clockdiv/mollusc-motion-hardware/mollusc_motion_board/v1.2/Screenshots/Screenshot 2024-01-08 at 12.20.10.png

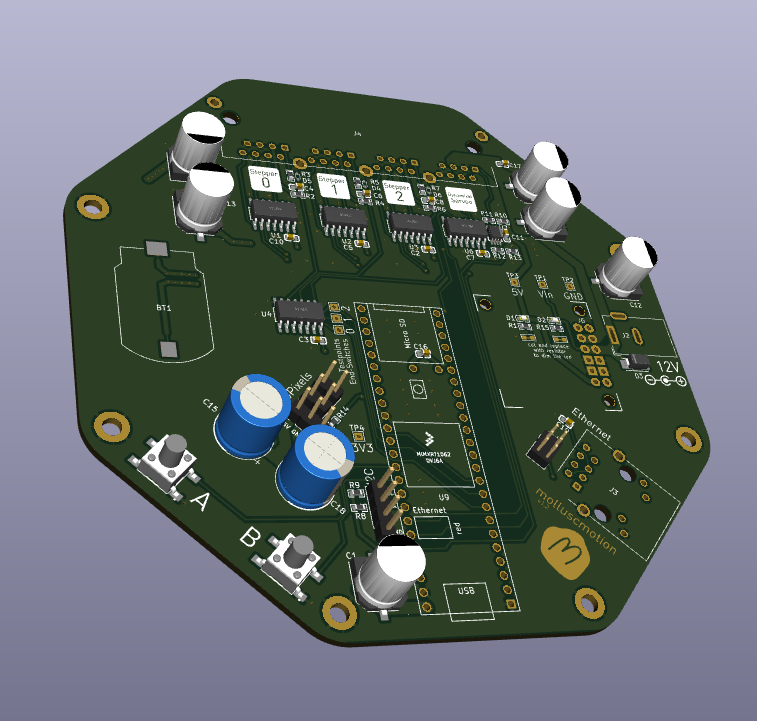
mollusc_motion_board/v1.2/Screenshots/Screenshot 2024-01-08 at 12.20.10.png
