clockdiv/mollusc-motion-hardware/20240207_mollusc_motion_board_v1-2.step

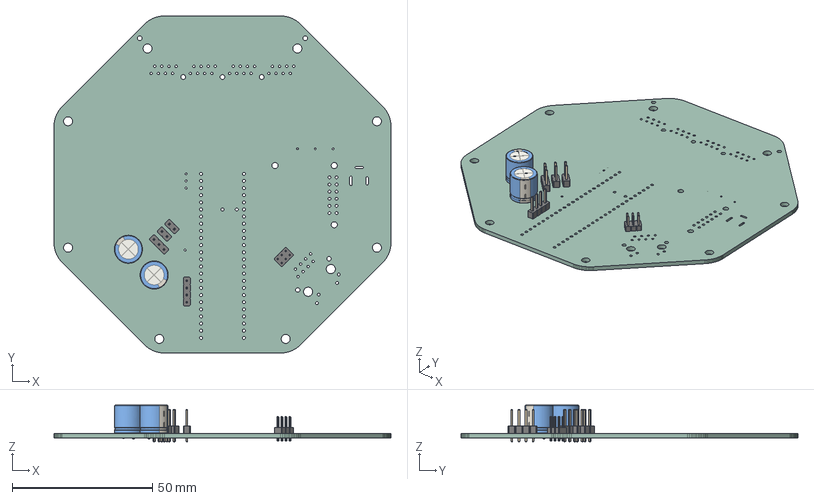
[picture p4: CAD file, 2024-07-25]
20240207_mollusc_motion_board_v1-2.step
120.0 x 120.0 x 13.0 mm
mollusc_motion_board PCB
