clockdiv/mollusc-motion-hardware/20240105_PCB_Outline_12cm.dxf

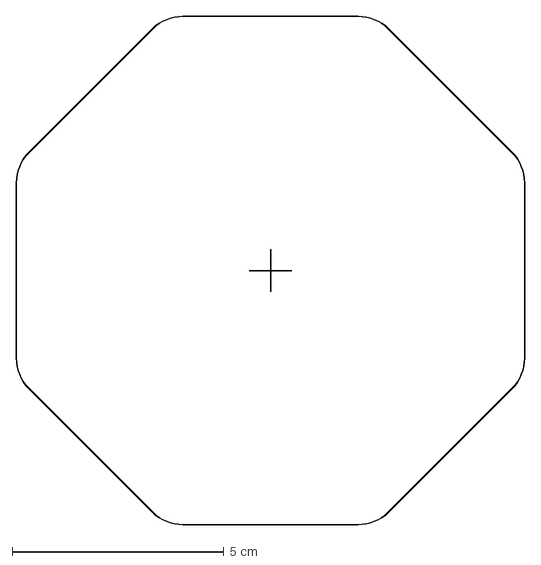
[picture p5: CAD file, 2024-01-05]
20240105_PCB_Outline_12cm.dxf
12.0 x 12.0 cm
