clockdiv/mollusc-motion-hardware/20240104_PCB_Outline_12cm.dxf

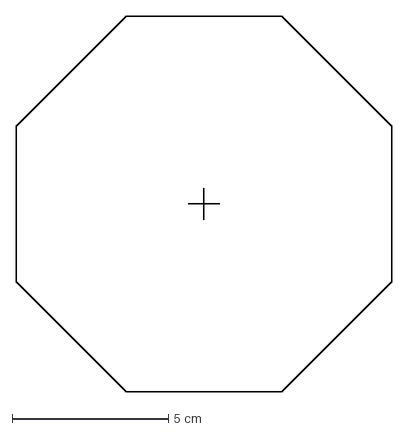
[picture p6: CAD file, 2024-01-04]
20240104_PCB_Outline_12cm.dxf
12.0 x 12.0 cm
