clockdiv/mollusc-motion-hardware/20240102_PCB_Outline_with_centerlines.dxf

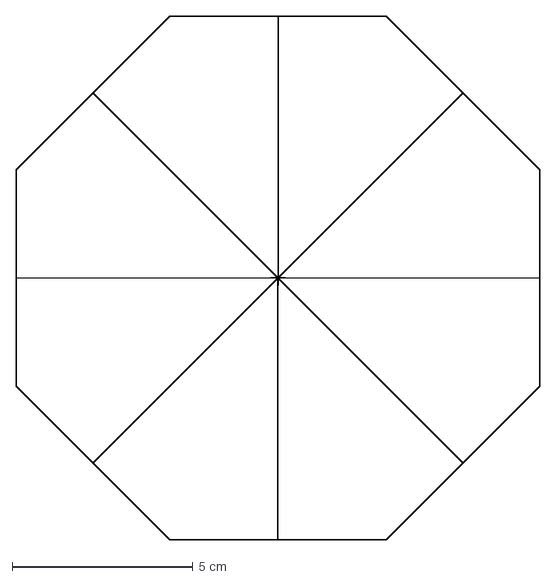
[picture p7: CAD file, 2024-01-04]
20240102_PCB_Outline_with_centerlines.dxf
14.5 x 14.5 cm
