clockdiv/mollusc-motion-hardware/20240104_Neopixel_Rings.dxf

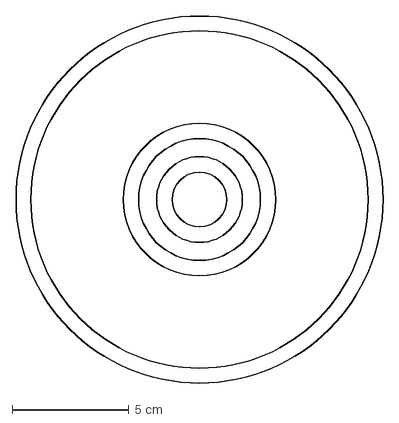
[picture p8: CAD file, 2024-01-04]
20240104_Neopixel_Rings.dxf
15.7 x 15.7 cm
