clockdiv/mollusc-motion-hardware/20240102_PCB_Outline.dxf

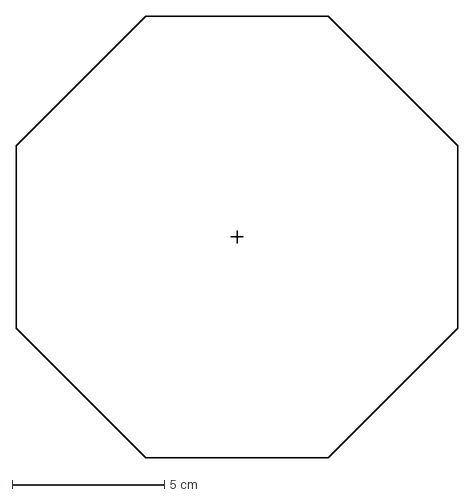
[picture p9: CAD file, 2024-01-04]
20240102_PCB_Outline.dxf
14.5 x 14.5 cm
