clockdiv/mollusc-motion-hardware/mollusc_motion_board/v1.2/20240124_Schematics.pdf

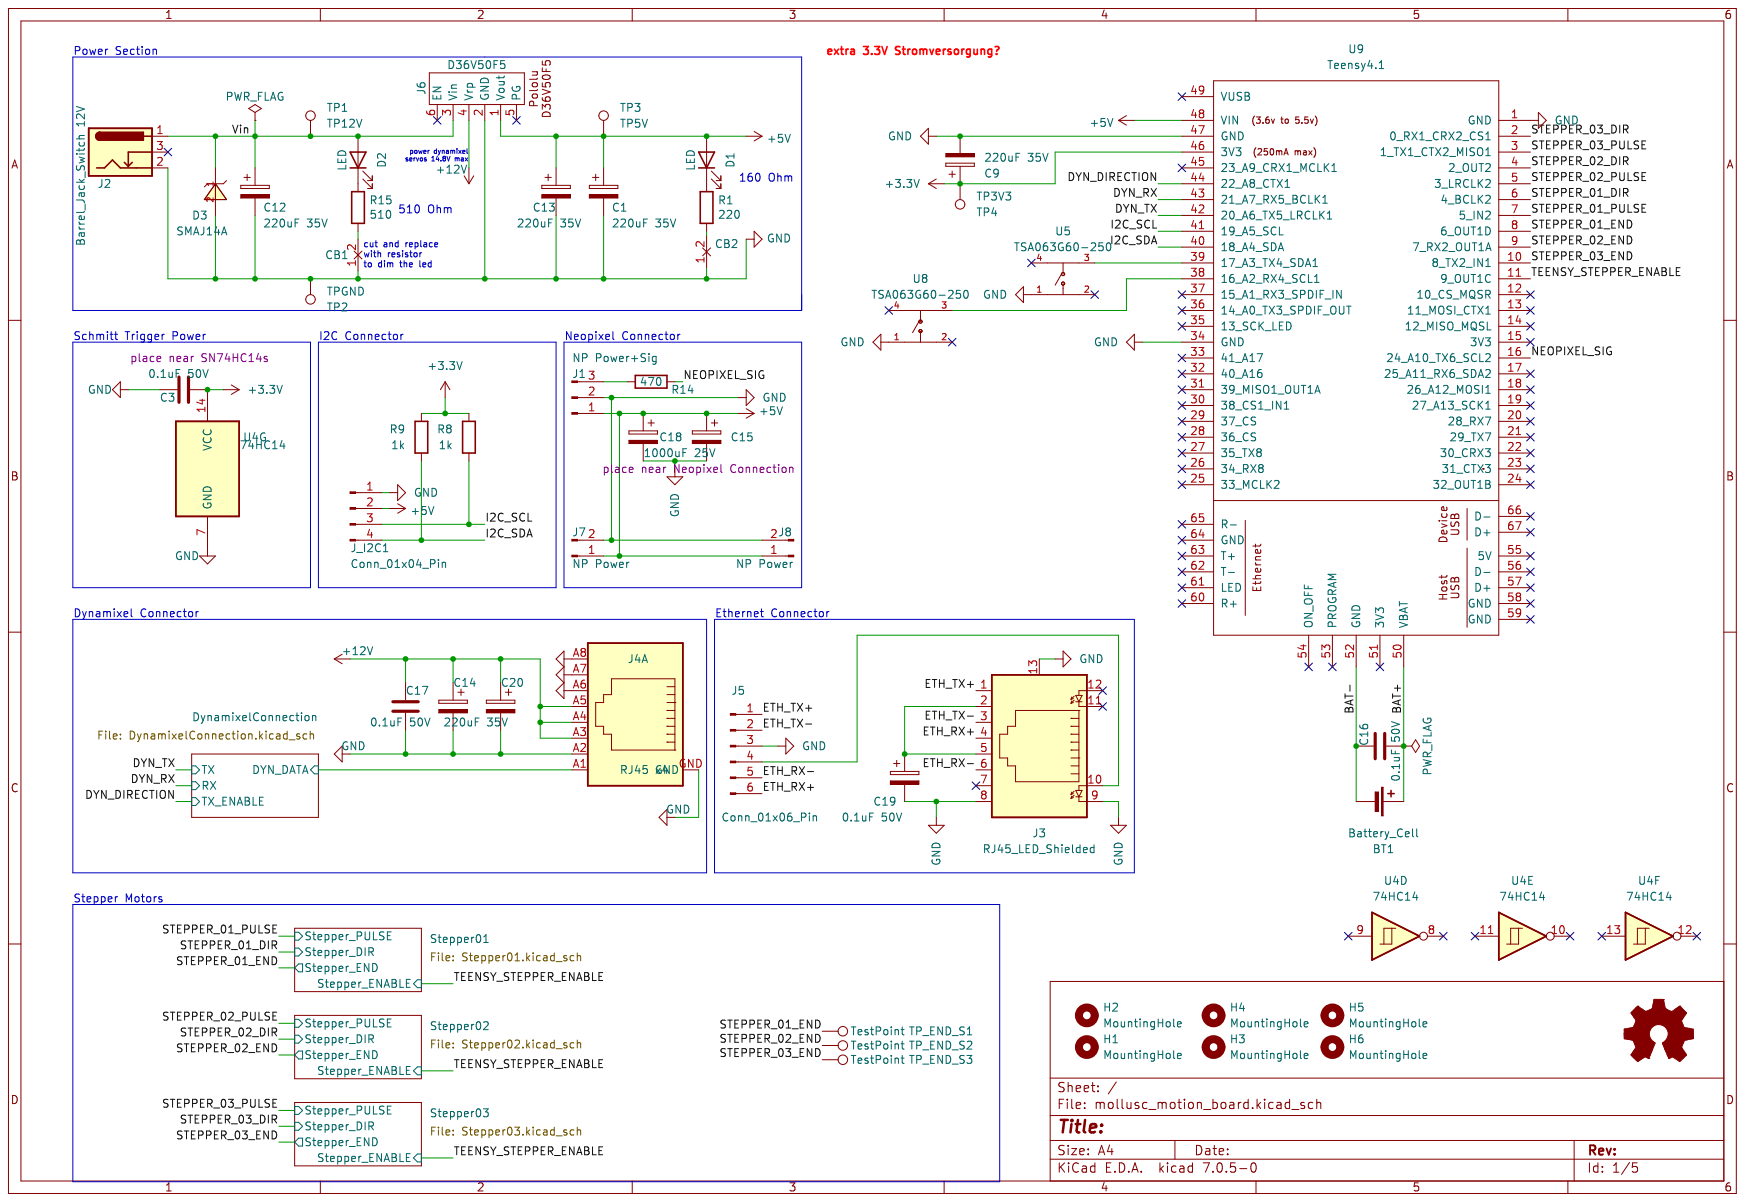
[picture p10: page 1]

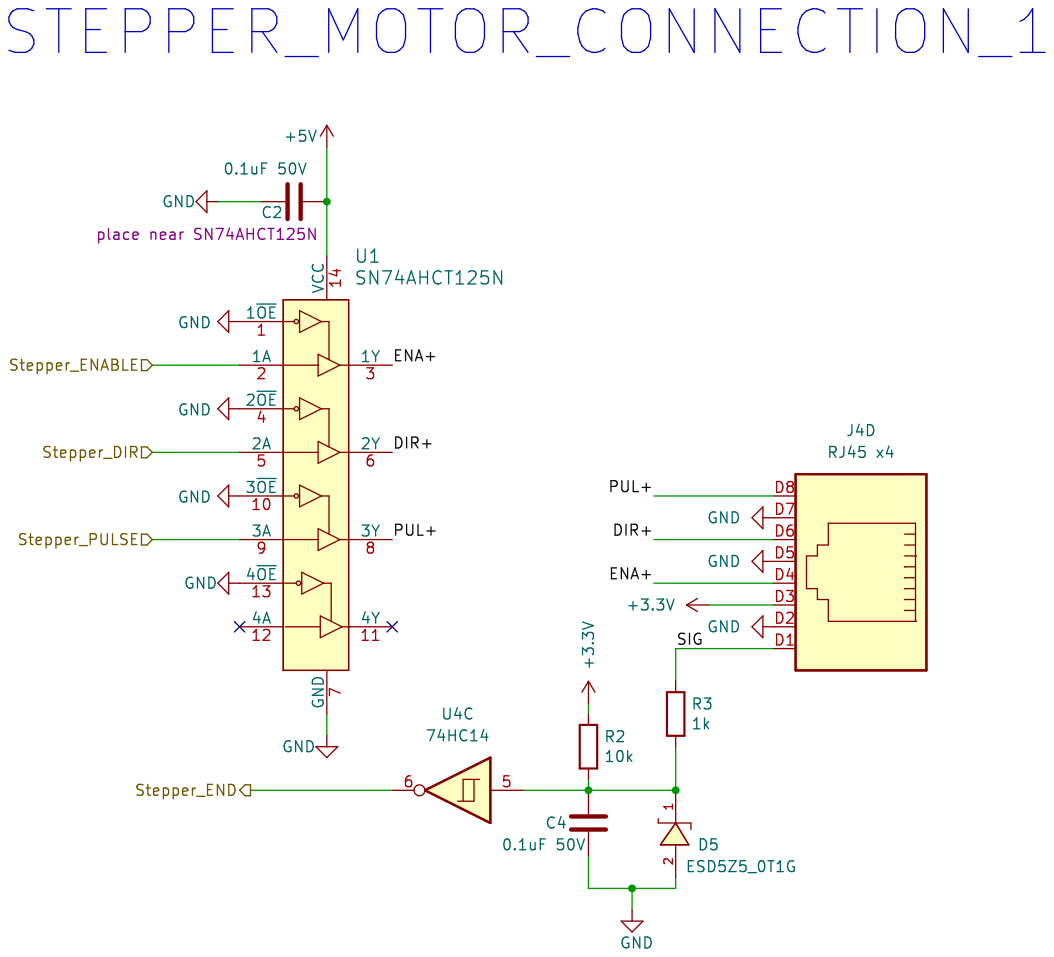
[picture p11: page 2]

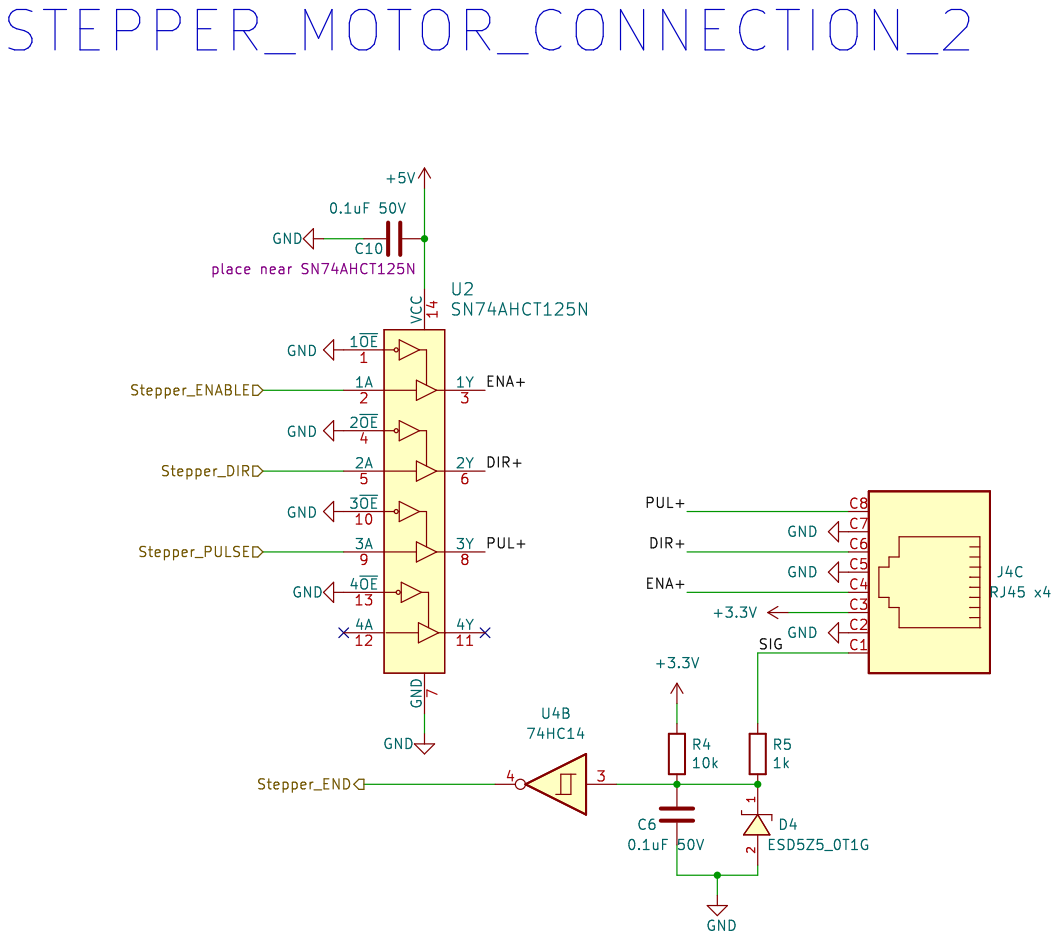
[picture p12: page 3]

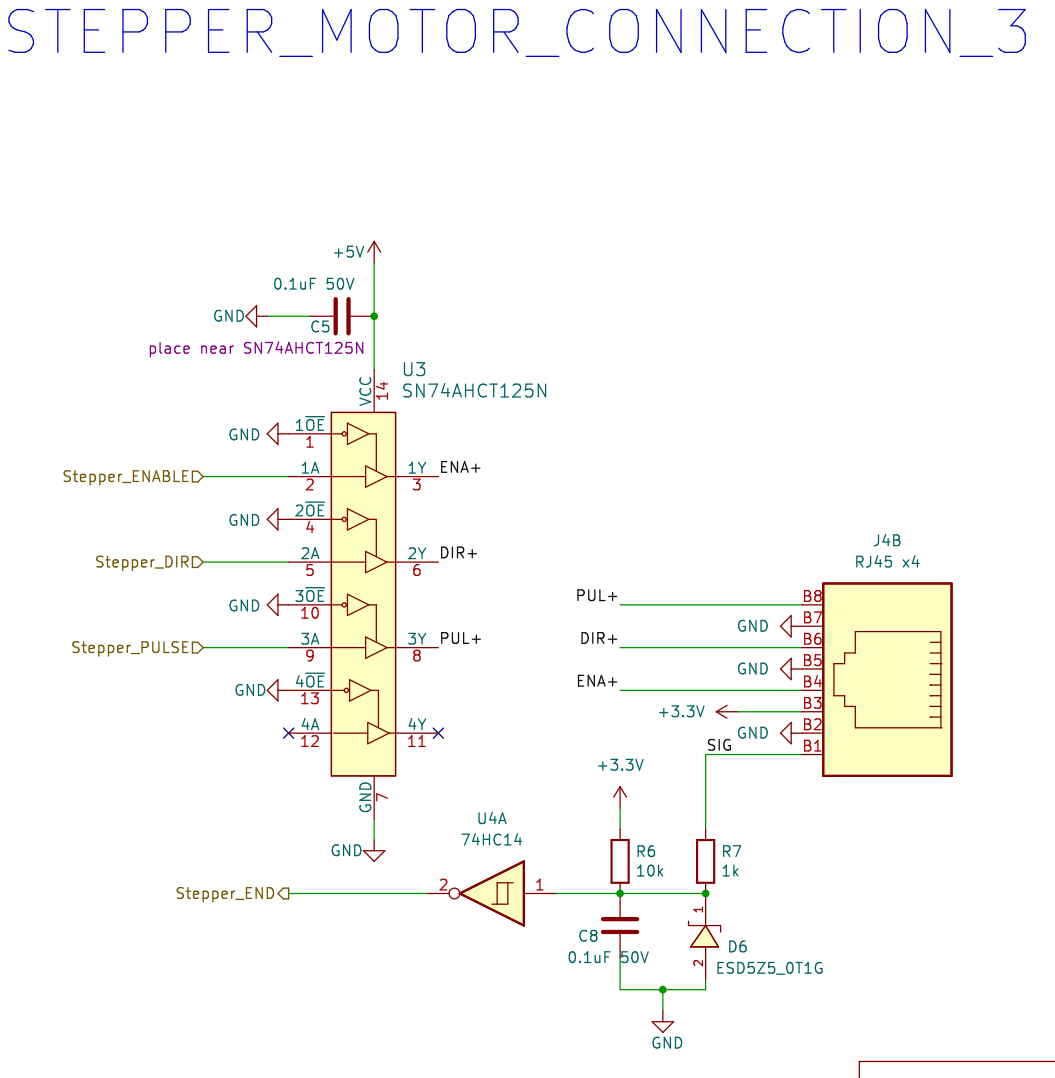
[picture p13: page 4]

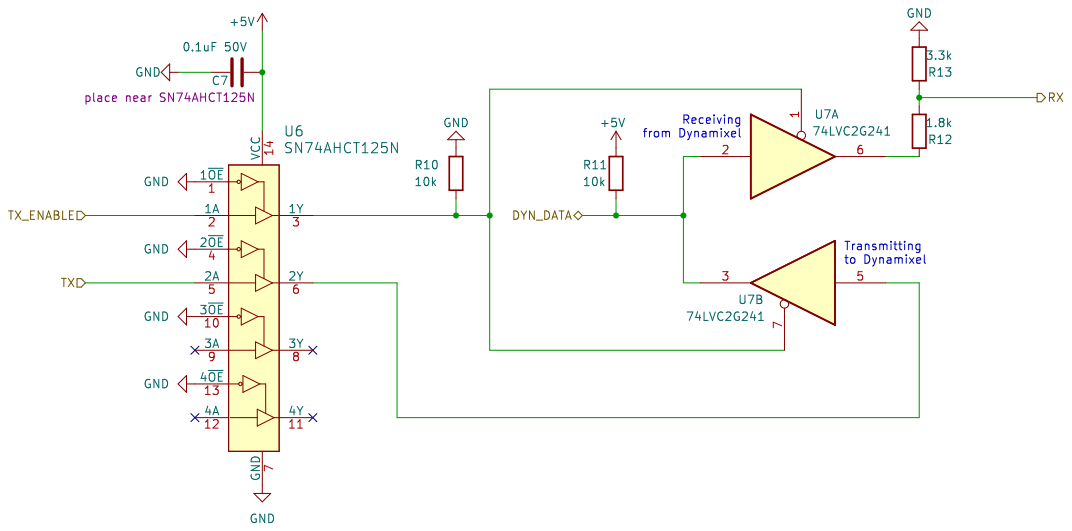
[picture p14: page 5]
