clockdiv/mollusc-motion-hardware/mollusc_motion_rj45-dynamixel-adapter/rj45-dynamixel-adapter.kicad_pcb

## KiCad design mollusc_motion_rj45-dynamixel-adapter/rj45-dynamixel-adapter.kicad_pcb (2024-08-13)

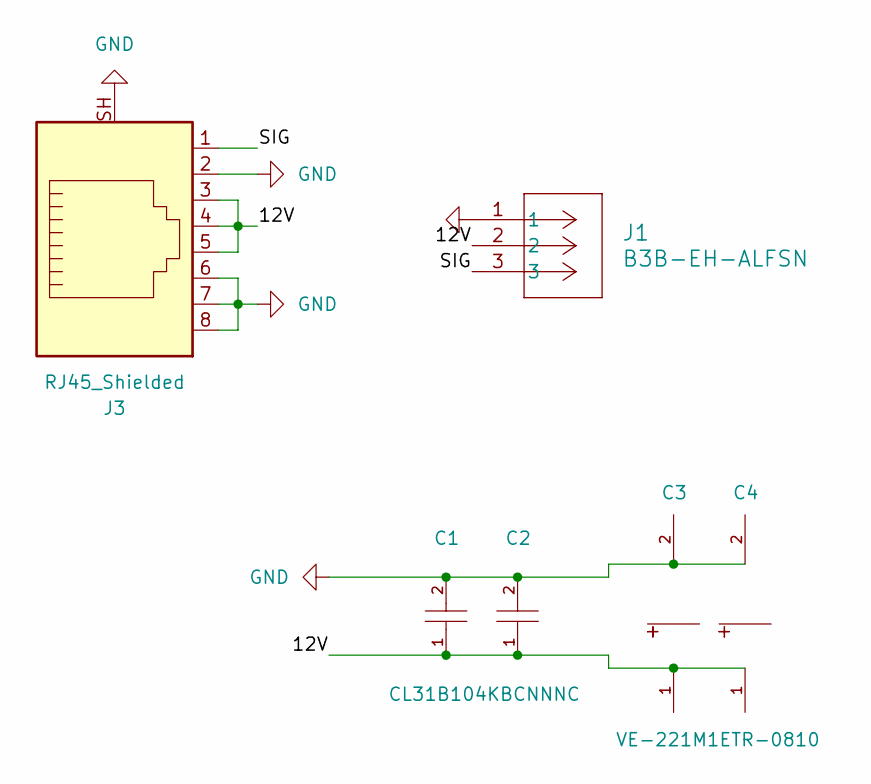
[picture p15: schematic rj45-dynamixel-adapter.kicad_sch]

Parts:
C1, C2: CL31B104KBCNNNC; C1206; LCSC C24497
C3, C4: VE-221M1ETR-0810; CAP-SMD_BD8.0-L8.3-W8.3-RD; LCSC C127967
J1: B3B-EH-ALFSN; CONN3_B3B-EH-ALFSN_JST
J3: RJ45_Shielded; RJ45_Conrad_1586526

Connections:
/12V: C1.1, C2.1, C3.1, C4.1, J1.2, J3.3, J3.4, J3.5
/SIG: J1.3, J3.1
GND: C1.2, C2.2, C3.2, C4.2, J1.1, J3.2, J3.6, J3.7, J3.8, J3.SH

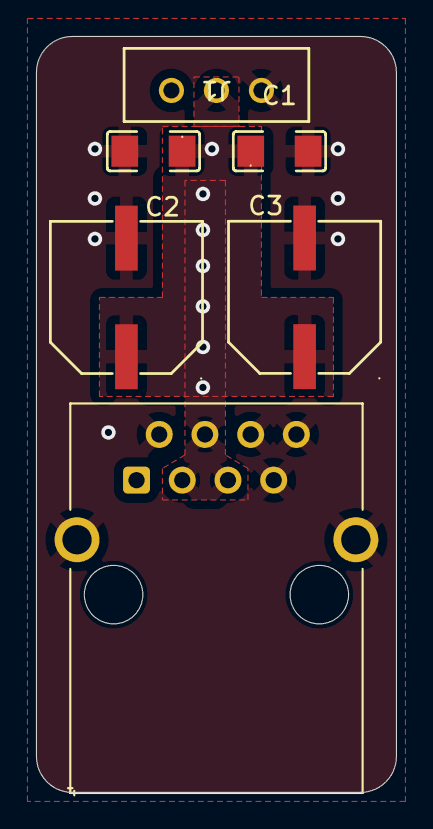
[picture p16: board rj45-dynamixel-adapter.kicad_pcb from above]

Board: 4 copper layers, 20.0 x 42.0 mm, 6 parts (0 on the bottom side), 3 nets.
