clockdiv/mollusc-motion-hardware/mollusc_motion_rj45-stepper-adapter_CL57T/rj45-stepper-adapter.kicad_pcb

## KiCad design mollusc_motion_rj45-stepper-adapter_CL57T/rj45-stepper-adapter.kicad_pcb (2024-07-25)

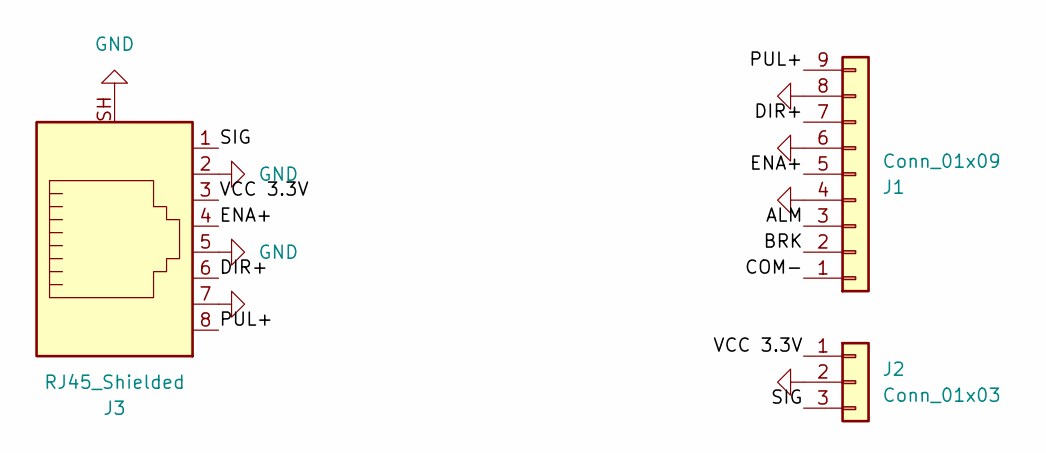
[picture p17: schematic rj45-stepper-adapter.kicad_sch]

Parts:
J1: Conn_01x09; Terminalblock_1x9_3.5mm
J2: Conn_01x03; PinHeader_1x03_P2.54mm_Vertical
J3: RJ45_Shielded; RJ45_Conrad_1586526

Connections:
/ALM: J1.3
/BRK: J1.2
/COM-: J1.1
/DIR+: J1.7, J3.6
/ENA+: J1.5, J3.4
/PUL+: J1.9, J3.8
/SIG: J2.3, J3.1
/VCC 3.3V: J2.1, J3.3
GND: J1.4, J1.6, J1.8, J2.2, J3.2, J3.5, J3.7, J3.SH

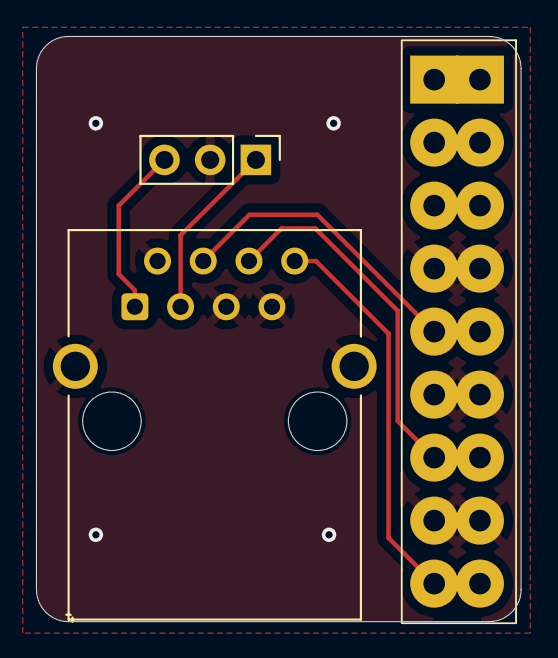
[picture p18: board rj45-stepper-adapter.kicad_pcb from above]

Board: 2 copper layers, 26.9 x 32.5 mm, 3 parts (0 on the bottom side), 6 nets.
