clockdiv/mollusc-motion-hardware/JST_EH_2.5mm_ExtensionBoard/JST_EH_2.5mm_ExtensionBoard/JST_EH_2.5mm_ExtensionBoard.kicad_pcb

## KiCad design JST_EH_2.5mm_ExtensionBoard/JST_EH_2.5mm_ExtensionBoard/JST_EH_2.5mm_ExtensionBoard.kicad_pcb (2024-07-25)

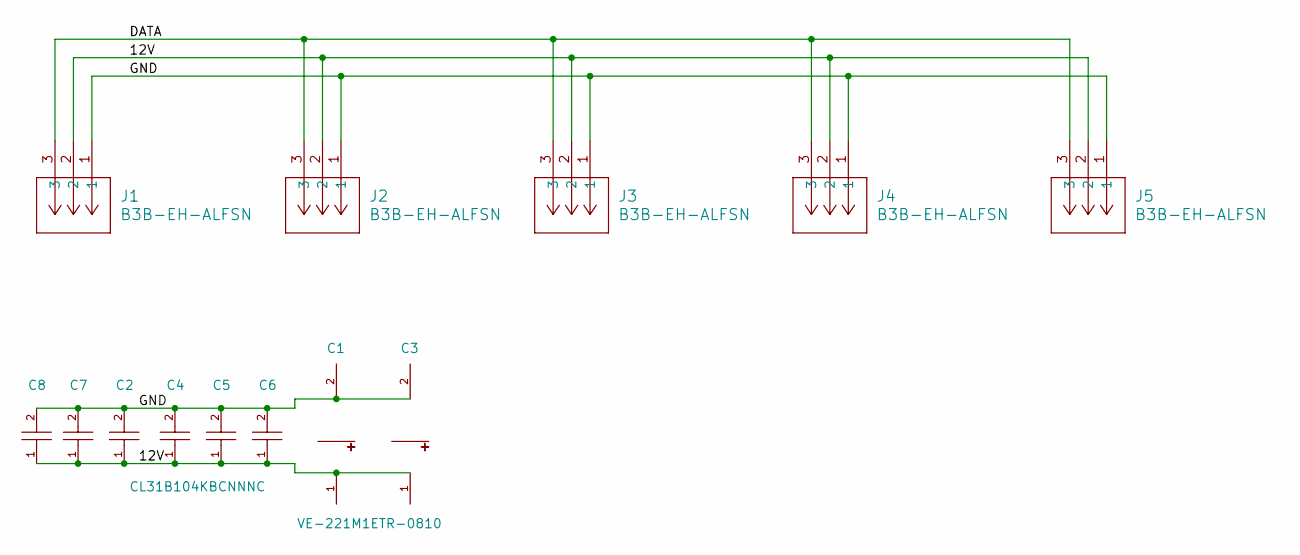
[picture p19: schematic JST_EH_2.5mm_ExtensionBoard.kicad_sch]

Parts:
C1, C3: VE-221M1ETR-0810; CAP-SMD_BD8.0-L8.3-W8.3-RD; LCSC C127967
C2, C4, C5, C6, C7, C8: CL31B104KBCNNNC; C1206; LCSC C24497
J1, J2, J3, J4, J5: B3B-EH-ALFSN; CONN3_B3B-EH-ALFSN_JST

Connections:
/12V: C1.1, C2.1, C3.1, C4.1, C5.1, C6.1, C7.1, C8.1, J1.2, J2.2, J3.2, J4.2, J5.2
/DATA: J1.3, J2.3, J3.3, J4.3, J5.3
/GND: C1.2, C2.2, C3.2, C4.2, C5.2, C6.2, C7.2, C8.2, J1.1, J2.1, J3.1, J4.1, J5.1

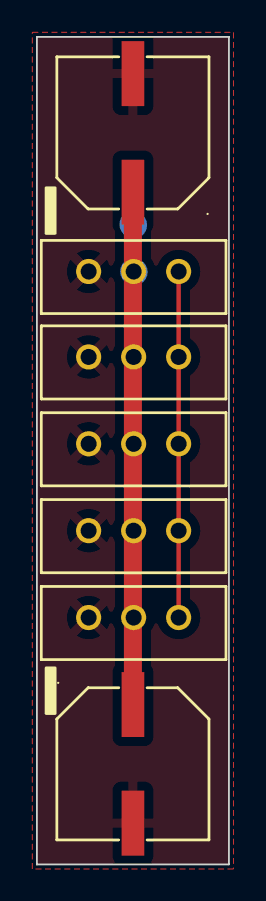
[picture p20: board JST_EH_2.5mm_ExtensionBoard.kicad_pcb from above]

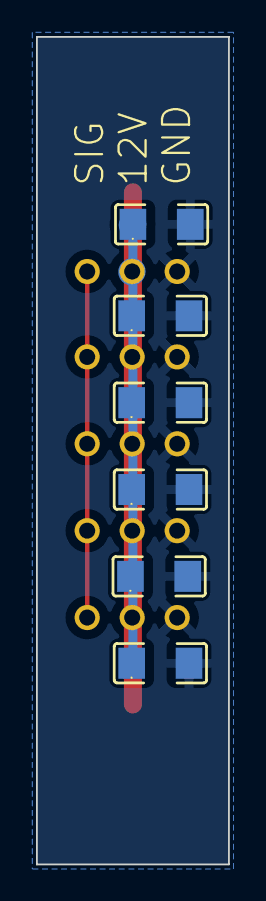
[picture p21: board JST_EH_2.5mm_ExtensionBoard.kicad_pcb from below]

Board: 2 copper layers, 10.7 x 46.0 mm, 13 parts (6 on the bottom side), 3 nets.
