clockdiv/mollusc-motion-hardware/mollusc_motion_board/mollusc_motion_board.kicad_pcb

## KiCad design mollusc_motion_board/mollusc_motion_board.kicad_pcb (2024-01-08)

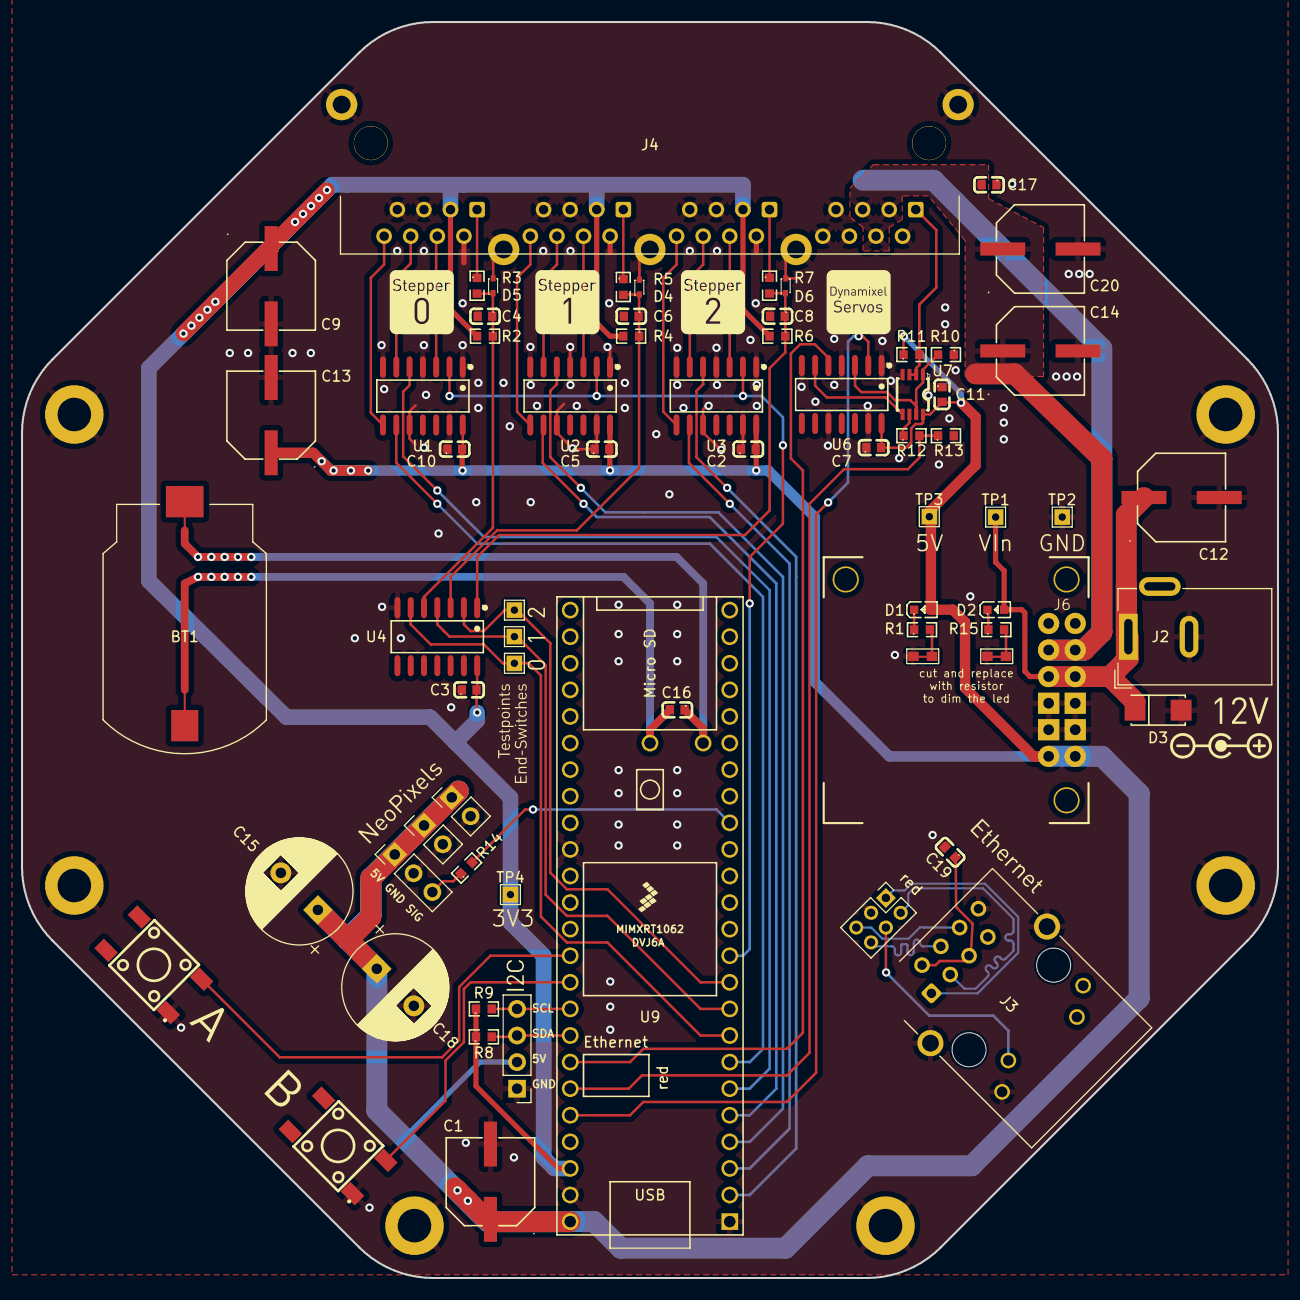
[picture p22: board mollusc_motion_board.kicad_pcb from above]

Board: 4 copper layers, 120.0 x 120.0 mm, 75 parts (0 on the bottom side), 55 nets.

Parts:
BT1: Battery_Cell; BAT_S8421-45R
C1, C9, C12, C13, C14, C20: 220uF 35V; CAP-SMD_BD8.0-L8.3-W8.3-LS9.9-FD
C2, C3, C4, C5, C6, C7, C8, C10, C11, C16, C17, C19: 0.1uF 50V; C0603
C15, C18: 1000uF 25V; CP_Radial_D10.0mm_P5.00mm
CB1, CB2: CircuitBreaker_1P_closed; CircuitBreaker_0603_closed
D1, D2: LED; LED0603-RD
D3: SMAJ14A; SMA_L4.3-W2.6-LS5.1-RD
D4, D5, D6: ESD5Z5_0T1G; SOD-523F_L1.2-W0.8-LS1.7-RD
H1, H2, H3, H4, H5, H6: MountingHole; MountingHole_3.2mm_M3_DIN965_Pad
J1: NP Power+Sig; PinHeader_1x03_P2.54mm_Vertical
J2: Barrel_Jack_Switch 12V; BarrelJack_Wuerth_6941xx301002
J3: RJ45_LED_Shielded; RJ45_Cetus_J1B1211CCD_Horizontal
J4: RJ45 x4; RJ45_x4
J5: Conn_01x06_Pin; PinHeader_2x03_P2.00mm_Vertical
J6: D36V50F5; Pololu_5V_5.5A_Step-Down_Voltage_Regulator_D36V50F5
J7, J8: NP Power; PinHeader_1x02_P2.54mm_Vertical
J_I2C1: Conn_01x04_Pin; PinHeader_1x04_P2.54mm_Vertical
R1: 220; R0603
R2, R4, R6, R10, R11: 10k; R0603
R3, R5, R7, R8, R9: 1k; R0603
R12: 1.8k; R0603
R13: 3.3k; R0603
R14: 470; R0603
R15: 510; R0603
TP1: TP12V; TestPoint_THTPad_1.5x1.5mm_Drill0.7mm
TP2: TPGND; TestPoint_THTPad_1.5x1.5mm_Drill0.7mm
TP3: TP5V; TestPoint_THTPad_1.5x1.5mm_Drill0.7mm
TP4: TP3V3; TestPoint_THTPad_1.5x1.5mm_Drill0.7mm
TP_END_S1, TP_END_S2, TP_END_S3: TestPoint; TestPoint_THTPad_1.5x1.5mm_Drill0.7mm
U1, U2, U3, U6: SN74AHCT125N; SOIC-14_L8.7-W3.9-P1.27-LS6.0-BL
U4: 74HC14; SOIC-14_L8.7-W3.9-P1.27-LS6.0-BL
U5, U8: TSA063G60-250; KEY-SMD_4P-L6.1-W6.1-P4.50-LS9.0
U7: 74LVC2G241; SSOP-8_L3.0-W2.8-P0.65-LS4.0-BL
U9: Teensy4.1; Teensy41

Connections:
+3.3V: C3.2, C9.1, J4.B3, J4.C3, J4.D3, R2.2, R4.2, R6.2, R8.1, R9.1, TP4.1, U4.14 (VCC), U9.46 (3V3)
+5V: C1.1, C2.2, C5.2, C7.2, C10.2, C11.2, C13.1, C15.1, C18.1, D1.2 (A), J1.1, J6.1 (Vout), J7.1, J8.1, J_I2C1.2, R11.1, TP3.1, U1.14 (VCC), U2.14 (VCC), U3.14 (VCC), U6.14 (VCC), U7.8 (VCC), U9.48 (VIN)
+12V: C14.1, C17.2, C20.1, J4.A3, J4.A4, J4.A5, J6.4 (Vrp)
/BAT+: BT1.1 (+), C16.1, U9.50 (VBAT)
/BAT-: BT1.2 (-), C16.2, U9.52 (GND)
/DYN_DIRECTION: U6.2 (1A), U9.44 (22_A8_CTX1)
/DYN_RX: R12.2, R13.1, U9.43 (21_A7_RX5_BCLK1)
/DYN_TX: U6.5 (2A), U9.42 (20_A6_TX5_LRCLK1)
/DynamixelConnection/DYN_DATA: J4.A1, R11.2, U7.2, U7.3
/ETH_RX+: J3.4, J5.6
/ETH_RX-: J3.6, J5.5
/ETH_TX+: J3.1, J5.1
/ETH_TX-: J3.3, J5.2
/I2C_SCL: J_I2C1.3, R8.2, U9.41 (19_A5_SCL)
/I2C_SDA: J_I2C1.4, R9.2, U9.40 (18_A4_SDA)
/NEOPIXEL_SIG: R14.2, U9.16 (24_A10_TX6_SCL2)
/STEPPER_01_DIR: U1.5 (2A), U9.6 (4_BCLK2)
/STEPPER_01_END: TP_END_S1.1, U4.6, U9.8 (6_OUT1D)
/STEPPER_01_PULSE: U1.9 (3A), U9.7 (5_IN2)
/STEPPER_02_DIR: U2.5 (2A), U9.4 (2_OUT2)
/STEPPER_02_END: TP_END_S2.1, U4.4, U9.9 (7_RX2_OUT1A)
/STEPPER_02_PULSE: U2.9 (3A), U9.5 (3_LRCLK2)
/STEPPER_03_DIR: U3.5 (2A), U9.2 (0_RX1_CRX2_CS1)
/STEPPER_03_END: TP_END_S3.1, U4.2, U9.10 (8_TX2_IN1)
/STEPPER_03_PULSE: U3.9 (3A), U9.3 (1_TX1_CTX2_MISO1)
/Stepper01/DIR+: J4.D6, U1.6 (2Y)
/Stepper01/ENA+: J4.D4, U1.3 (1Y)
/Stepper01/PUL+: J4.D8, U1.8 (3Y)
/Stepper01/SIG: J4.D1, R3.1
/Stepper02/DIR+: J4.C6, U2.6 (2Y)
/Stepper02/ENA+: J4.C4, U2.3 (1Y)
/Stepper02/PUL+: J4.C8, U2.8 (3Y)
/Stepper02/SIG: J4.C1, R5.1
/Stepper03/DIR+: J4.B6, U3.6 (2Y)
/Stepper03/ENA+: J4.B4, U3.3 (1Y)
/Stepper03/PUL+: J4.B8, U3.8 (3Y)
/Stepper03/SIG: J4.B1, R7.1
/TEENSY_STEPPER_ENABLE: U1.2 (1A), U2.2 (1A), U3.2 (1A), U9.11 (9_OUT1C)
/Vin: C12.1, D2.2 (A), D3.1, J2.1, J6.3 (Vin), TP1.1
GND: C1.2, C2.1, C3.1, C4.2, C5.1, C6.2, C7.1, C8.2, C9.2, C10.1, C11.1, C12.2, C13.2, C14.2, C15.2, C17.1, C18.2, C19.2, C20.2, CB1.1, CB2.1, D3.2, D4.2 (A), D5.2 (A), D6.2 (A), H1.1, H2.1, H3.e, H4.1, H5.1, H6.1, J1.2, J2.2, J3.8, J3.9, J3.13, J4.A2, J4.A6, J4.A7, J4.A8, J4.B2, J4.B5, J4.B7, J4.C2, J4.C5, J4.C7, J4.D2, J4.D5, J4.D7, J4.GND, J5.3, J6.2 (GND), J7.2, J8.2, J_I2C1.1, R10.1, R13.2, TP2.1, U1.1 (1~OE), U1.4 (2~OE), U1.7 (GND), U1.10 (3~OE), U1.13 (4~OE), U2.1 (1~OE), U2.4 (2~OE), U2.7 (GND), U2.10 (3~OE), U2.13 (4~OE), U3.1 (1~OE), U3.4 (2~OE), U3.7 (GND), U3.10 (3~OE), U3.13 (4~OE), U4.7 (GND), U5.1, U6.1 (1~OE), U6.4 (2~OE), U6.7 (GND), U6.10 (3~OE), U6.13 (4~OE), U7.4 (GND), U8.1, U9.1 (GND), U9.34 (GND), U9.47 (GND)
unnamed: C19.1, J3.2, J3.5
unnamed: CB1.2, R15.2
unnamed: CB2.2, R1.2
unnamed: D1.1 (K), R1.1
unnamed: D2.1 (K), R15.1
unnamed: C6.1, D4.1 (C), R4.1, R5.2, U4.3
unnamed: C4.1, D5.1 (C), R2.1, R3.2, U4.5
unnamed: C8.1, D6.1 (C), R6.1, R7.2, U4.1
unnamed: J1.3, R14.1
unnamed: J3.10, J5.4
unnamed: R12.1, U7.6
unnamed: R10.2, U6.3 (1Y), U7.1, U7.7
unnamed: U6.6 (2Y), U7.5
unnamed: U8.3, U9.38 (16_A2_RX4_SCL1)
unnamed: U5.3, U9.39 (17_A3_TX4_SDA1)
