clockdiv/mollusc-motion-hardware/(commit log)

2023-10-11 initial commit
    Board v2.0 with Steppers and Dynamixels
    - bug with swapped connection on Stepper is resolved
    [DynamixelConnection.kicad_sch, Stepper01.kicad_sch, Stepper02.kicad_sch, Stepper03.kicad_sch, mollusc_motion_board.kicad_pcb, mollusc_motion_board.kicad_sch, rj45-stepper-adapter.kicad_pcb, rj45-stepper-adapter.kicad_sch]
2023-10-13 v3
    in production
    [rj45-stepper-adapter-B_Cu.gbr, rj45-stepper-adapter-B_Mask.gbr, rj45-stepper-adapter-B_Paste.gbr, rj45-stepper-adapter-B_Silkscreen.gbr, rj45-stepper-adapter-Edge_Cuts.gbr, rj45-stepper-adapter-F_Cu.gbr, rj45-stepper-adapter-F_Mask.gbr, rj45-stepper-adapter-F_Paste.gbr]
2023-12-29 adding BOM
    renaming to 'mollusc_motion'
    [BOM.csv, DynamixelConnection.kicad_sch, Stepper01.kicad_sch, Stepper02.kicad_sch, Stepper03.kicad_sch, mollusc_motion_board.csv, mollusc_motion_board.kicad_pcb, mollusc_motion_board.kicad_sch]
2023-12-29 adding ethernet jack
    [Stepper01.kicad_sch, Stepper02.kicad_sch, Stepper03.kicad_sch, mollusc_motion_board.kicad_pcb, mollusc_motion_board.kicad_sch]
2024-01-04 Board v2 wip
    [20240102_PCB_Outline.dxf, 20240102_PCB_Outline_with_centerlines.dxf, 20240104_Neopixel_Rings.dxf, 20240104_PCB_Outline_12cm.dxf, BOM-mollusc_motion_board.csv, BOM.csv, DynamixelConnection.kicad_sch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]
2024-01-05 PCB v1.2 Layout
    [20240105_PCB_Outline_12cm.dxf, BOM.csv, BOM.xls, DynamixelConnection.kicad_sch, Stepper01.kicad_sch, Stepper02.kicad_sch, Stepper03.kicad_sch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]
2024-01-08 PCB v1.2
    v1.2, produced by JLCPCB
    [20240108_PowerConsumption.xls, BOM-mollusc_motion_board.csv, BOM.xls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]
2024-01-26 backup pcb v1.2
    clean-up of the directory
    [20240108_PowerConsumption.xls, 20240124_BOM.csv, BOM-mollusc_motion_board.csv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]
2024-07-25 added JST-Header Extension Board
    tiny board to wire five Dynamixels in parallel
    [20240207_mollusc_motion_board_v1-2.step, BOM-JST_EH_2.csv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]
2024-07-25 Adapter for CL57T Stepper-Driver
    [BOM-rj45-stepper-adapter.csv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]
